rom98759/EventBadge/enclosure/images/explorations/B_5_coupe.png

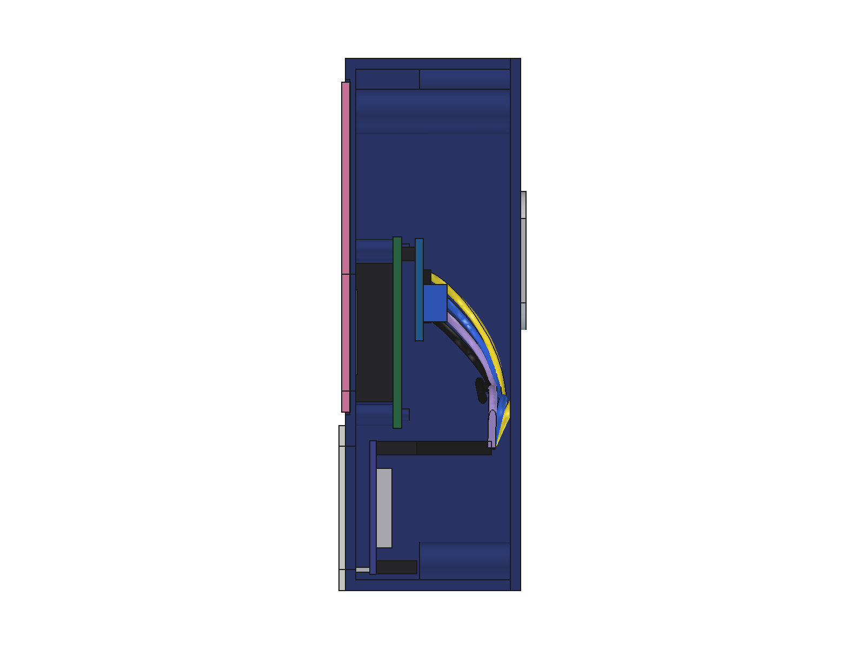
enclosure/images/explorations/B_5_coupe.png
