rom98759/EventBadge/enclosure/images/explorations/C_2_iso.png

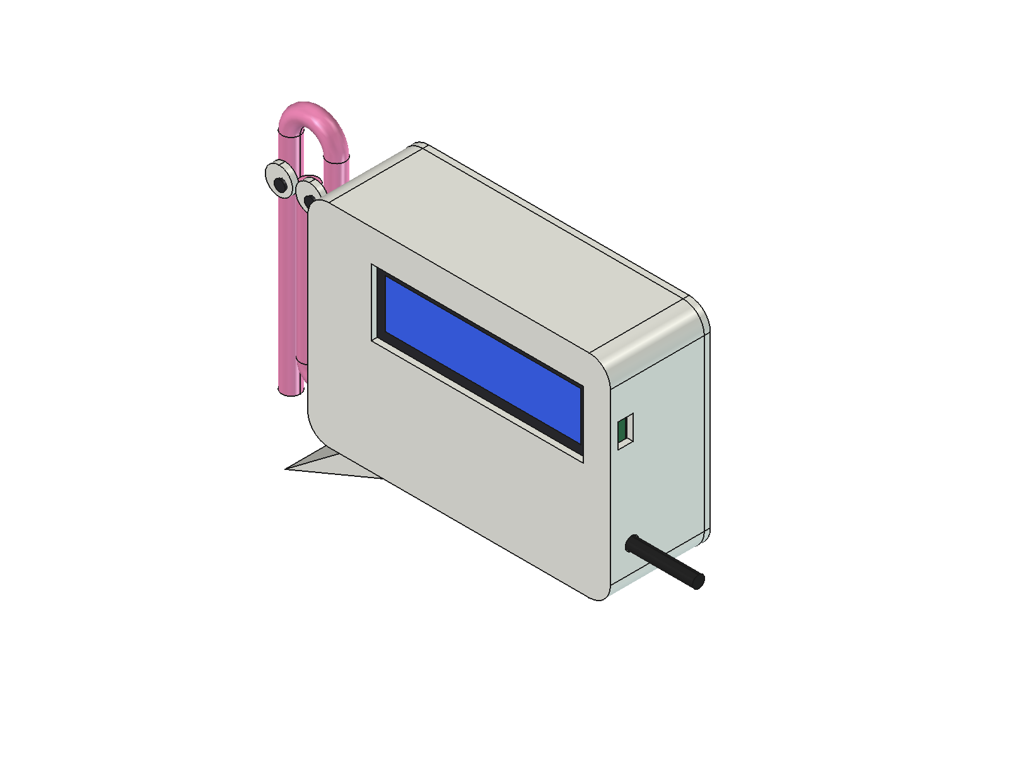
enclosure/images/explorations/C_2_iso.png
