rom98759/EventBadge/enclosure/images/final/final_usb_dessus.png

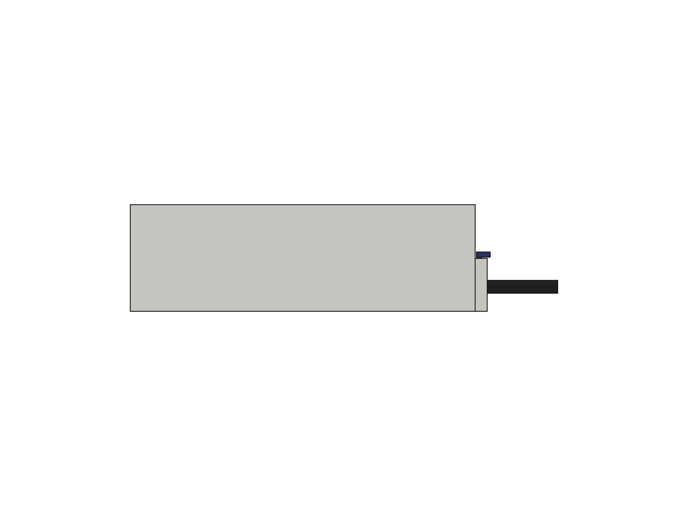
enclosure/images/final/final_usb_dessus.png
