rom98759/EventBadge/web/assets/profil-128.png

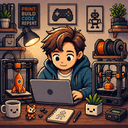
web/assets/profil-128.png
