rom98759/EventBadge/EventBadge.ino

#include <ESP8266WiFi.h>
#include <ESP8266WebServer.h>
#include <DNSServer.h>
#include <EEPROM.h>
#include <LittleFS.h>
#include <Wire.h>
#include <hd44780.h>
#include <hd44780ioClass/hd44780_I2Cexp.h>

#include "config.h"
#include "portal.h"
#include "admin.h"
#include "EventLog.h"
#include "WifiNames.h"

#if __has_include("secrets.h")
#include "secrets.h"
#else
#error "Copy secrets.example.h to secrets.h and set ADMIN_KEY"
#endif

extern "C" {
#include <user_interface.h>
}

// Deliberately not a private address: some Android builds (seen on a Samsung
// S23, Android 16) treat a probe hostname resolving to a private IP as "no
// internet" and never send the captive-portal probe. The network is isolated,
// so this public-looking address is never routed anywhere.
const IPAddress AP_IP(4, 3, 2, 1);
const uint32_t SCREEN_MS = 4500;   // time on each resting screen
const uint8_t SCREENS = 5;
const uint32_t SCROLL_MS = 500;     // per character when the hotspot name scrolls
const uint32_t SCROLL_HOLD_MS = 2000;  // pause at each end of the scroll
const uint8_t TEXT_W = 14;          // columns 0 and 15 are kept for glyphs
const uint32_t ALERT_MS = 3000;    // time the "new connection" alert stays up
const uint32_t FLASH_MS = 160;     // backlight blink half-period during an alert
const uint32_t LCD_CHECK_MS = 2000; // how often to look for the screen / check it is still there

hd44780_I2Cexp lcd;
DNSServer dns;
ESP8266WebServer server(80);
WiFiEventHandler onConnect;
WiFiEventHandler onDisconnect;

enum Glyph : uint8_t { SKULL, WIFI, CHIP, RIGHT, LEFT, LINK };

uint8_t glyphs[][8] = {
  {0b01110, 0b11111, 0b10101, 0b11111, 0b10101, 0b01110, 0b01010, 0b00000},  // skull
  {0b00000, 0b10000, 0b10100, 0b10101, 0b10101, 0b10101, 0b00000, 0b00000},  // wifi bars
  {0b00000, 0b01110, 0b10001, 0b10101, 0b10001, 0b01110, 0b00000, 0b00000},  // chip
  {0b00000, 0b01000, 0b01100, 0b01110, 0b01100, 0b01000, 0b00000, 0b00000},  // arrow right
  {0b00000, 0b00010, 0b00110, 0b01110, 0b00110, 0b00010, 0b00000, 0b00000},  // arrow left
  {0b00000, 0b00110, 0b01001, 0b10110, 0b01101, 0b10010, 0b01100, 0b00000},  // chain link
};

// Anonymous counts, kept across reboots in EEPROM. `connections` is set from
// the AP connect event (ISR-like context), so it is volatile and read with
// interrupts briefly disabled. `clicks` is bumped from the web handler.
volatile uint16_t connections = 0;
uint16_t clicks = 0;

// Persistence: a tiny record in EEPROM-emulated flash, saved debounced.
struct Stats { uint16_t magic; uint16_t conn; uint16_t clk; };
const uint16_t STATS_MAGIC = 0x4201;
const uint32_t SAVE_AFTER_MS = 8000;  // debounce flash writes
bool statsDirty = false;
uint32_t statsChangedAt = 0;

uint8_t screen = 0;
uint32_t screenAt = 0;
uint32_t alertUntil = 0;
uint32_t flashAt = 0;
bool backlightOn = true;
bool alertPending = false;

// The portal must keep working with the screen missing or unplugged, so the
// LCD is optional: drawing is skipped while it is absent and it is brought up
// whenever it (re)appears on the bus.
bool lcdReady = false;
uint32_t lcdCheckAt = 0;

// hd44780_I2Cexp's auto-locate counter is static and advances on every failed
// begin(), so retrying begin() with no device would later skip the real one.
// Probe the expander ranges ourselves and only call begin() once one answers.
bool expanderPresent() {
  for (uint8_t a = 0x20; a <= 0x3F; a++) {
    if (a == 0x28) a = 0x38;  // PCF8574/MCP23008 0x20-0x27, PCF8574A 0x38-0x3F
    Wire.beginTransmission(a);
    if (Wire.endTransmission() == 0) return true;
  }
  return false;
}

bool lcdAnswers() {
  uint8_t addr = lcd.getProp(hd44780_I2Cexp::Prop_addr);
  if (!addr) return expanderPresent();
  Wire.beginTransmission(addr);
  return Wire.endTransmission() == 0;
}

// A replugged LCD has lost its state, so (re)appearing always means a full begin().
void syncLcd() {
  bool present = lcdAnswers();
  if (present == lcdReady) return;
  lcdReady = false;
  if (!present) {
    Serial.println(F("LCD: lost, running without it"));
    return;
  }
  int status = lcd.begin(16, 2);
  if (status) {
    Serial.printf("LCD: init failed (%d), will retry\n", status);
    return;
  }
  for (uint8_t i = 0; i < sizeof(glyphs) / sizeof(glyphs[0]); i++)
    lcd.createChar(i, glyphs[i]);
  lcdReady = true;
  backlightOn = true;
  Serial.println(F("LCD: ready"));
}

// setCursor/write lets a custom glyph sit inside a text line.
void putGlyph(uint8_t col, uint8_t row, uint8_t g) {
  lcd.setCursor(col, row);
  lcd.write(g);
}

void printLine(uint8_t row, const char *text) {
  char buf[17];
  snprintf(buf, sizeof(buf), "%-16s", text);
  lcd.setCursor(0, row);
  lcd.print(buf);
}

// Center text in `width` columns starting at `from`, blanking the rest of
// that span only, so glyphs on either side are left alone.
void printCentered(uint8_t row, const char *text, uint8_t from = 0, uint8_t width = 16) {
  char buf[17];
  int len = strlen(text);
  if (len > width) len = width;
  int pad = (width - len) / 2;
  memset(buf, ' ', width);
  memcpy(buf + pad, text, len);
  buf[width] = '\0';
  lcd.setCursor(from, row);
  lcd.print(buf);
}

// Text between two glyphs: the layout rule that keeps glyphs off the letters.
void printFramed(uint8_t row, const char *text, uint8_t left, uint8_t right) {
  putGlyph(0, row, left);
  printCentered(row, text, 1, TEXT_W);
  putGlyph(15, row, right);
}


uint16_t readConnections() {
  noInterrupts();
  uint16_t c = connections;
  interrupts();
  return c;
}

void loadStats() {
  Stats s;
  EEPROM.get(0, s);
  if (s.magic == STATS_MAGIC) {
    connections = s.conn;
    clicks = s.clk;
  }
}

void saveStats() {
  Stats s = { STATS_MAGIC, readConnections(), clicks };
  EEPROM.put(0, s);
  EEPROM.commit();
}

void markDirty() {
  statsDirty = true;
  statsChangedAt = millis();
}

// Offset of a text longer than the window: scrolls forward, pauses, scrolls
// back, pauses, so the whole hotspot name can be read.
uint8_t scrollOffset(uint8_t len, uint8_t width, uint32_t t) {
  if (len <= width) return 0;
  uint32_t span = len - width, run = span * SCROLL_MS;
  t %= 2 * (SCROLL_HOLD_MS + run);
  if (t < SCROLL_HOLD_MS) return 0;
  t -= SCROLL_HOLD_MS;
  if (t < run) return t / SCROLL_MS;
  t -= run;
  if (t < SCROLL_HOLD_MS) return span;
  t -= SCROLL_HOLD_MS;
  return span - min<uint32_t>(span, t / SCROLL_MS);
}

// The hotspot screen stays up for one full back-and-forth of a long name.
uint32_t screenMs(uint8_t which) {
  uint8_t len = strlen(ssidCurrent());
  if (which != 0 || len <= TEXT_W) return SCREEN_MS;
  return 2 * (SCROLL_HOLD_MS + (len - TEXT_W) * SCROLL_MS) + 600;
}

uint8_t ssidShown = 255;  // offset on screen, 255 = redraw

void drawSsid(uint32_t t) {
  if (!lcdReady) return;
  const char *name = ssidCurrent();
  uint8_t len = strlen(name), off = scrollOffset(len, TEXT_W, t);
  if (off == ssidShown) return;
  ssidShown = off;
  if (len <= TEXT_W) {
    printCentered(1, name, 1, TEXT_W);
    return;
  }
  char buf[TEXT_W + 1];
  for (uint8_t i = 0; i < TEXT_W; i++) {
    char c = name[off + i];
    buf[i] = (c >= 32 && c <= 126) ? c : '?';  // the LCD ROM has no UTF-8
  }
  buf[TEXT_W] = '\0';
  lcd.setCursor(1, 1);
  lcd.print(buf);
}

void drawResting(uint8_t which) {
  if (!lcdReady) return;
  lcd.clear();
  char buf[TEXT_W + 1];
  switch (which) {
    case 0:
      printFramed(0, "CONNECTE-TOI", WIFI, WIFI);
      putGlyph(0, 1, RIGHT);
      putGlyph(15, 1, LEFT);
      ssidShown = 255;
      drawSsid(0);
      break;
    case 1:
      printCentered(0, CFG_NAME);
      printFramed(1, CFG_ROLE, CHIP, CHIP);
      break;
    case 2:
      printCentered(0, "Etudiant 42");
      printCentered(1, "stage pentest");
      break;
    case 3:
      printFramed(0, "ALTERNANCE", RIGHT, LEFT);
      printCentered(1, CFG_WHEN);
      break;
    case 4:
      snprintf(buf, sizeof(buf), "%-10s%03u", "Curieux", readConnections());
      putGlyph(0, 0, SKULL);
      lcd.setCursor(1, 0);
      lcd.print(buf);
      snprintf(buf, sizeof(buf), "%-10s%03u", "Liens", clicks);
      putGlyph(0, 1, LINK);
      lcd.setCursor(1, 1);
      lcd.print(buf);
      break;
  }
}

void drawAlert() {
  if (!lcdReady) return;
  lcd.clear();
  printFramed(0, "+1 CURIEUX !", WIFI, WIFI);
  printCentered(1, "bienvenue a toi");
}

void logRequest(const char *reply) {
#if CFG_LOG_HTTP
  Serial.printf("[http] %s %s%s -> %s | %s\n",
                server.method() == HTTP_GET ? "GET" : "OTHER",
                server.hostHeader().c_str(), server.uri().c_str(), reply,
                server.header("User-Agent").c_str());
#endif
}

// HTTP handlers only see an IP; the AP's station list maps it back to the MAC.
// Changing the name restarts the AP, which drops every connected phone.
void startAp() {
  WiFi.softAP(ssidCurrent(), nullptr, 1, false, CFG_MAX_CLIENTS);
  logEvent(EV_SSID, 0, ssidHash(ssidCurrent()), 0);
  Serial.printf("AP \"%s\" up at %s\n", ssidCurrent(), AP_IP.toString().c_str());
  if (screen == 0 && !alertUntil) drawResting(0);
}

uint32_t apRestartAt = 0;  // deferred so the admin's reply gets out before the AP drops

uint32_t clientVisitor() {
  IPAddress ip = server.client().remoteIP();
  uint32_t v = 0;
  for (station_info *s = wifi_softap_get_station_info(); s; s = STAILQ_NEXT(s, next)) {
    if (IPAddress(s->ip.addr) == ip) {
      v = visitorId(s->bssid);
      break;
    }
  }
  wifi_softap_free_station_info();
  return v;
}

uint32_t argU32(const char *name) {
  return strtoul(server.arg(name).c_str(), nullptr, 10);
}

// Same identity and links as the portal page, as a contact card visitors can
// keep: the links cannot open from the portal, a contact stays on the phone.
const char CONTACT_VCF[] PROGMEM =
  "BEGIN:VCARD\r\n"
  "VERSION:3.0\r\n"
  "N:Caillier;Romain;;;\r\n"
  "FN:Romain Caillier\r\n"
  "TITLE:Dév & Sécurité · École 42 Angoulême\r\n"
  "NOTE:Cherche une alternance en développement\\, sécurité ou DevSecOps dès juin 2027.\r\n"
  "URL:https://caillier-romain.fr/\r\n"
  "URL:https://github.com/rom98759/\r\n"
  "URL:https://www.linkedin.com/in/romain-caillier\r\n"
  "END:VCARD\r\n";

void handleContact() {
  server.sendHeader("Content-Disposition", "attachment; filename=\"Romain-Caillier.vcf\"");
  server.send_P(200, "text/vcard; charset=utf-8", CONTACT_VCF);
}

// Every probe and stray app request lands here once DNS points everything at
// the badge. A tiny redirect keeps those cheap, so the radio and the
// single-threaded loop (DNS included) stay free for the one real page load.
void redirectToPortal() {
  static const String target = String("http://") + AP_IP.toString() + "/";
  server.sendHeader("Location", target);
  server.send(302, "text/plain", "");
}

// Served from one host only, so phones cache the page and its images once
// rather than per probe hostname.
void handleRoot() {
  const String &host = server.hostHeader();
  if (host.length() && host != AP_IP.toString()) {
    logRequest("redirect");
    redirectToPortal();
    return;
  }
  logRequest("portal");
  server.sendHeader("ETag", PORTAL_ETAG);
  server.sendHeader("Cache-Control", "no-cache");
  if (server.header("If-None-Match") == PORTAL_ETAG) {
    server.send(304, "text/plain", "");
    return;
  }
  server.sendHeader("Content-Encoding", "gzip");
  server.send_P(200, "text/html; charset=utf-8", (PGM_P)PORTAL_GZ, sizeof(PORTAL_GZ));
}

// Image URLs carry a content hash, so they can be cached for good.
void sendAsset(const PortalAsset &a) {
  server.sendHeader("Cache-Control", "public, max-age=31536000, immutable");
  server.send_P(200, a.mime, (PGM_P)a.data, a.len);
}

// "connections,clicks,hotspot name": real counters and the name in use. The
// name goes last because it may itself contain commas.
void handleCount() {
  char buf[52];
  snprintf(buf, sizeof(buf), "%u,%u,%s", readConnections(), clicks, ssidCurrent());
  server.send(200, "text/plain", buf);
}

// Beacon fired by the page when a contact link is copied.
void handleClick() {
  clicks++;
  markDirty();
  logEvent(EV_CLICK, argU32("l"), 0, clientVisitor());
  server.send(204, "text/plain", "");
}

// Sent by the page on load: the phone's clock is the badge's only time source.
void handleHi() {
  logEvent(EV_VIEW, argU32("d"), argU32("t"), clientVisitor());
  server.send(204, "text/plain", "");
}

void handleBye() {
  logEvent(EV_LEAVE, 0, argU32("s"), clientVisitor());
  server.send(204, "text/plain", "");
}

// The admin page itself is public and holds no data; only the data endpoints
// check the key.
bool adminOk() {
  if (server.header("X-Key") == ADMIN_KEY) return true;
  server.send(401, "text/plain", "bad key");
  return false;
}

void handleAdmin() {
  server.send_P(200, "text/html; charset=utf-8", ADMIN_HTML);
}

// Raw log plus "boot,uptime_ms,connections,clicks,requester,full,free_heap,
// largest_block,fs_used,fs_total" in a header, so the page can date the
// current boot from its own clock, hide its owner and show the badge's health.
void handleAdminLog() {
  if (!adminOk()) return;
  logFlush(true);
  FSInfo fs = {};
  LittleFS.info(fs);
  char meta[112];
  snprintf(meta, sizeof(meta), "%u,%lu,%u,%u,%lu,%u,%lu,%lu,%lu,%lu", logBoot(),
           (unsigned long)millis(), readConnections(), clicks, (unsigned long)clientVisitor(),
           logFull(), (unsigned long)ESP.getFreeHeap(), (unsigned long)ESP.getMaxFreeBlockSize(),
           (unsigned long)fs.usedBytes, (unsigned long)fs.totalBytes);
  server.sendHeader("X-Badge", meta);
  server.sendHeader("Cache-Control", "no-store");
  File f = LittleFS.open(LOG_PATH, "r");
  if (f) server.streamFile(f, "application/octet-stream");
  else server.send(200, "application/octet-stream", "");
}

void handleAdminWifi() {
  if (!adminOk()) return;
  if (server.method() == HTTP_POST) {
    int r = ssidSetConfig(server.arg("plain"));
    if (r < 0) {
      server.send(400, "text/plain", "no name");
      return;
    }
    if (r > 0) apRestartAt = millis() + 1500;
  }
  server.send(200, "text/plain; charset=utf-8", ssidConfigText());
}

void handleAdminWifiUse() {
  if (!adminOk()) return;
  if (server.method() != HTTP_POST) {
    server.send(405, "text/plain", "POST only");
    return;
  }
  int r = ssidUse(server.arg("plain"));
  if (r < 0) {
    server.send(404, "text/plain", "unknown name");
    return;
  }
  if (r > 0) apRestartAt = millis() + 1500;
  server.send(200, "text/plain; charset=utf-8", ssidConfigText());
}

void handleAdminReset() {
  if (!adminOk()) return;
  if (server.method() != HTTP_POST) {
    server.send(405, "text/plain", "POST only");
    return;
  }
  logReset();
  noInterrupts();
  connections = 0;
  interrupts();
  clicks = 0;
  saveStats();
  drawResting(screen);
  server.send(204, "text/plain", "");
}

// OS captive-portal probes expect their own success response (Android wants
// HTTP 204, iOS wants the word "Success"). A redirect instead is what makes
// the phone decide it is behind a portal and pop the page open on its own,
// rather than just showing a silent "no internet".
void handleCaptive() {
  logRequest("redirect (probe)");
  redirectToPortal();
}

void setup() {
  Serial.begin(115200);
  delay(1000);

  EEPROM.begin(sizeof(Stats));
  loadStats();
  logBegin();
  ssidBegin();

  Wire.begin();
  syncLcd();
  if (lcdReady) {
    printLine(0, "EventBadge");
    printLine(1, "demarrage...");
  }

  // The SDK otherwise rewrites its config sector on every softAP() call,
  // which the name rotation would turn into steady flash wear.
  WiFi.persistent(false);
  WiFi.mode(WIFI_AP);
  WiFi.softAPConfig(AP_IP, AP_IP, IPAddress(255, 255, 255, 0));
  startAp();

  onConnect = WiFi.onSoftAPModeStationConnected(
    [](const WiFiEventSoftAPModeStationConnected &e) {
      connections++;
      alertPending = true;
      markDirty();
      logEvent(EV_CONNECT, e.aid, 0, visitorId(e.mac));
    });
  onDisconnect = WiFi.onSoftAPModeStationDisconnected(
    [](const WiFiEventSoftAPModeStationDisconnected &e) {
      logEvent(EV_DISCONNECT, e.aid, 0, visitorId(e.mac));
    });

  dns.setErrorReplyCode(DNSReplyCode::NoError);
  dns.start(53, "*", AP_IP);

  server.collectHeaders("User-Agent", "X-Key", "If-None-Match");
  server.on("/", handleRoot);
  for (const PortalAsset &a : PORTAL_ASSETS)
    server.on(a.path, HTTP_GET, [p = &a]() { sendAsset(*p); });
  server.on("/count", handleCount);
  server.on("/click", handleClick);
  server.on("/hi", handleHi);
  server.on("/bye", handleBye);
  server.on("/contact.vcf", handleContact);
  server.on("/admin", handleAdmin);
  server.on("/admin/log.bin", handleAdminLog);
  server.on("/admin/reset", handleAdminReset);
  server.on("/admin/wifi", handleAdminWifi);
  server.on("/admin/wifi/use", handleAdminWifiUse);
  // Common captive-portal detection URLs across platforms.
  server.on("/generate_204", handleCaptive);
  server.on("/gen_204", handleCaptive);
  server.on("/hotspot-detect.html", handleCaptive);
  server.on("/ncsi.txt", handleCaptive);
  server.onNotFound(handleCaptive);
  server.begin();

  screen = 0;
  drawResting(screen);
  screenAt = lcdCheckAt = millis();
}

void loop() {
  dns.processNextRequest();
  server.handleClient();

  uint32_t now = millis();

  if (now - lcdCheckAt >= LCD_CHECK_MS) {
    lcdCheckAt = now;
    bool wasReady = lcdReady;
    syncLcd();
    if (lcdReady && !wasReady) alertUntil ? drawAlert() : drawResting(screen);
  }

  logFlush();

  if (apRestartAt && (int32_t)(now - apRestartAt) >= 0) {
    apRestartAt = 0;
    startAp();
  } else if (ssidTick(WiFi.softAPgetStationNum())) {
    startAp();
  }

  // Persist the counts a few seconds after the last change (limits flash wear).
  if (statsDirty && now - statsChangedAt >= SAVE_AFTER_MS) {
    statsDirty = false;
    saveStats();
  }

  if (alertPending) {
    alertPending = false;
    alertUntil = now + ALERT_MS;
    flashAt = now;
    drawAlert();
  }

  if (alertUntil) {
    if (now - flashAt >= FLASH_MS) {
      flashAt = now;
      backlightOn = !backlightOn;
      if (lcdReady) backlightOn ? lcd.backlight() : lcd.noBacklight();
    }
    if (now >= alertUntil) {
      alertUntil = 0;
      if (!backlightOn) {
        backlightOn = true;
        if (lcdReady) lcd.backlight();
      }
      screenAt = now;
      drawResting(screen);
    }
    return;  // hold the alert; resting rotation resumes after it
  }

  if (screen == 0) drawSsid(now - screenAt);
  if (now - screenAt >= screenMs(screen)) {
    screen = (screen + 1) % SCREENS;
    screenAt = now;
    drawResting(screen);
  }
}
