rom98759/EventBadge/secrets.example.h

#pragma once

// Copy to secrets.h (gitignored) and set your own key. It unlocks the stats
// on http://4.3.2.1/admin; the portal is plain HTTP on an open network, so
// do not reuse a real password.
#define ADMIN_KEY "change-me"
