rom98759/EventBadge/(commit log)

2026-10-25 feat: EventBadge v1 — captive portal badge on D1 mini
2026-10-29 feat: switch hotspot name live and fit the admin page to phones
2026-10-30 perf: redirect probes, gzip the portal and serve images apart (#1)
    Every captive probe and stray request got the full 81 KB page, keeping the
    single-threaded loop and its DNS server busy while phones connected. Probes
    now get a tiny 302, the page is gzipped (10 KB) with an ETag, images are
    separate content-hash URLs cached by phones, and lwIP uses 1460-byte MSS.
2026-10-31 feat: add EventBadge Win95 enclosure CAD scripts
2026-10-31 docs: add the enclosure to the README
    CAD scripts now find their folder from __file__ instead of a fixed path, and the enclosure docs are in English like the rest of the repo.
